Alex-King-Dev/Autonomous-robotic-car-and-manipulator-arm/media/4.5cm.png

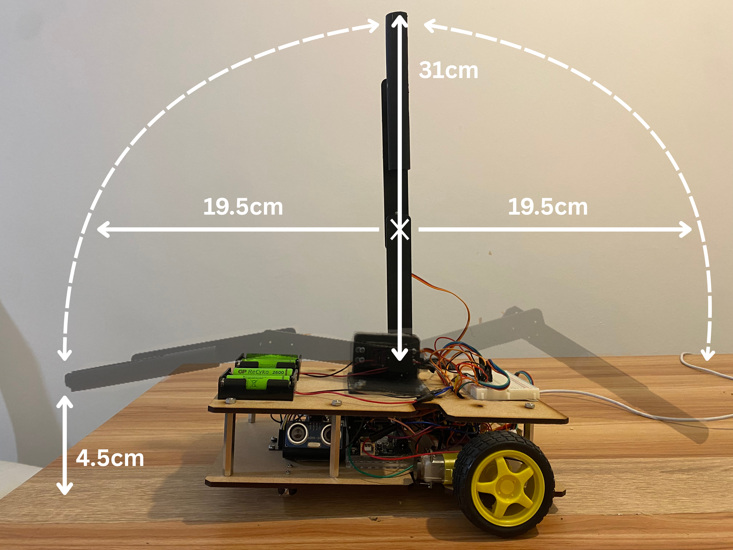
[picture p1: media/ProjectDimensions.png]
media/4.5cm.png
